Geekay-27/underwater-sonar-transmitter/docs/images/pins_dac_opamp.png

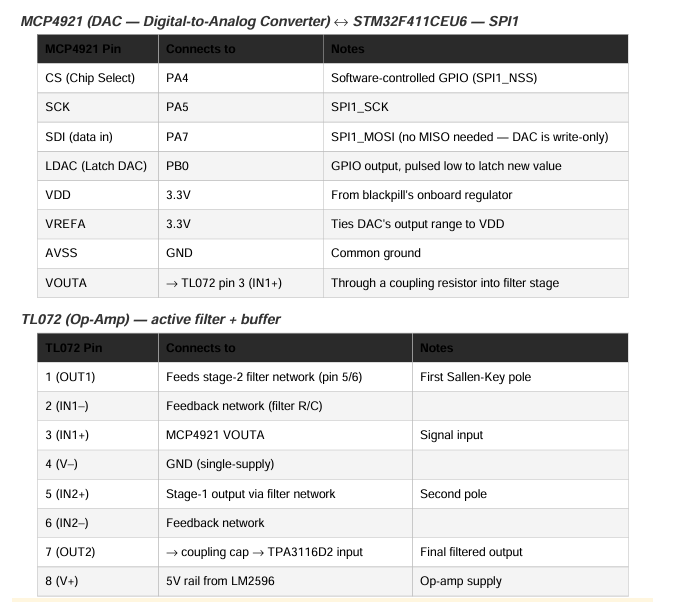
docs/images/pins_dac_opamp.png
