Geekay-27/underwater-sonar-transmitter/docs/images/pins_pots.png

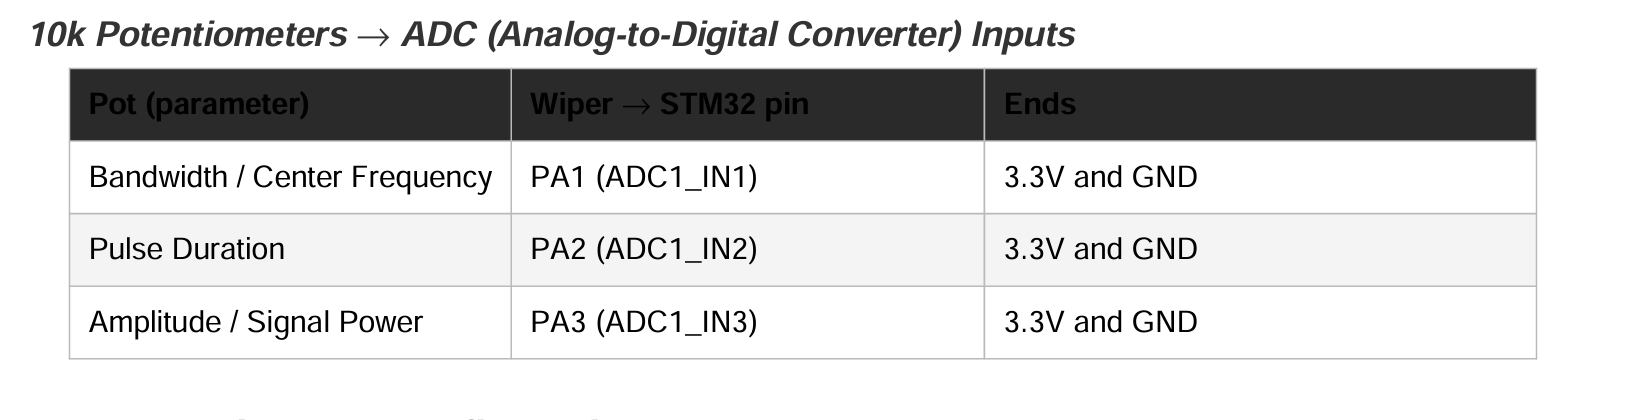
docs/images/pins_pots.png
