Geekay-27/underwater-sonar-transmitter/hardware/BOM.md

# Bill of materials

| Qty | Part | Notes |
|---|---|---|
| 1 | WeAct Black Pill STM32F411CEU6 | Transmitter MCU |
| 1 | MCP4921 12-bit SPI DAC | |
| 1 | LM358 dual op-amp (DIP-8) | Sallen-Key filter (replaces TL072) |
| 1 | TPA3116D2 class-D amplifier board | Drives the projector/transducer |
| 1 | LM2596 buck module | 5 V rail |
| 3 | 10 kΩ potentiometers | Simulated sensors |
| - | Resistors / capacitors for the filter | Choose values for f0 ≈ 40 – 60 kHz (see study guide section 6) |
| - | 100 nF capacitors | Wiper decoupling, supply decoupling |
| 1 | NUCLEO-F446RE | Scope |
| 1 | 1.8" ST7735 160×128 TFT | Scope display |
| 1 | Rotary encoder with switch | Scope gain |
| 1 | 3D-printed / fabricated pod | AUV hull-slot enclosure |
